Zikangz/Continuum-Soft-Arm-Controller/(commit log)

2026-06-13 Upload STM32 lower controller project
    [imu_pose_log.csv]
2026-06-13 Move STM32 lower controller files to repository root
    [imu_pose_log.csv]
2026-06-13 Add continuum arm project introduction
2026-06-13 Rename project to Continuum Soft Arm Controller
